locked/AppleII-VGA/(commit log)

2024-11-02 Add SMD version of the card
    For those that prefer soldering SMD or if like me
    you have some spare SMD only parts
    [AppleVGA.kicad_pcb, AppleVGA.kicad_sch]
2024-11-02 Finalize SMD version
    [AppleVGA.kicad_pcb]
